Paumanok/kasa-remote/README.md

# Kasa-remote

An ESP32 based remote control device for manipulating and monitoring TPLink Kasa devices.

Future plans include new control modules, power saving, and other nice-to-haves. 

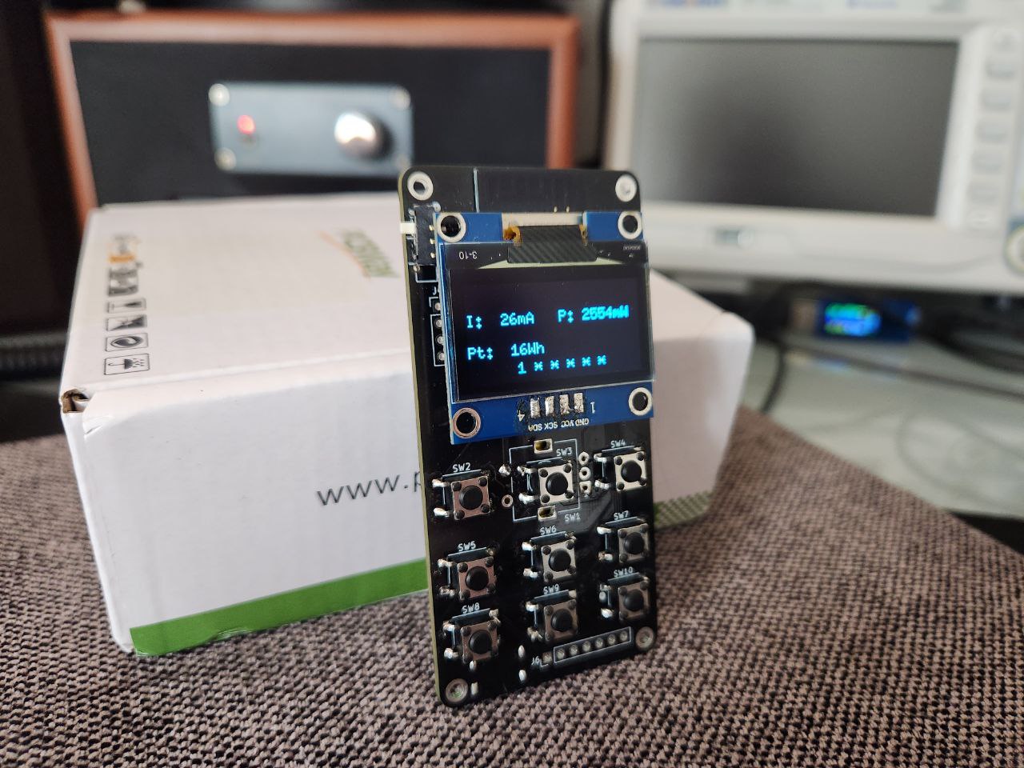
[picture p1: hardware/Assembled.jpg]
assembled


Leverages [rust_kasa](https://github.com/Paumanok/rust_kasa)
