Paumanok/kasa-remote/hardware/Documentation/kasa-remote-bom.ods

Source: | /home/matt/Documents/Projects/Hardware/kasa-remote/kasa-remote.kicad_sch
Date: | Mon 11 Mar 2024 04:03:01 PM EDT
Tool: | Eeschema 7.0.10
Generator: | /usr/share/kicad/plugins/bom_csv_grouped_by_value.py
Component Count: | 46
Collated Components:
Item | Qty | Owned | Reference(s) | Value | LibPart | Footprint | Datasheet | DNP | Availability | Check_prices | Description | MANUFACTURER | MAXIMUM_PACKAGE_HEIGHT | MF | MP | Mfg Part # | PARTREV | Package | Price | STANDARD | Sim.Device | Sim.Pins | Sim.Type | SnapEDA_Link | mpn
1 | 4 |  | C1, C2, C3, C4 | 10uf | Device:C_Small | Capacitor_SMD:C_0603_1608Metric | ~ |  |  |  | https://www.digikey.com/en/products/detail/taiyo-yuden/JMK107ABJ106MA-T/4970720
2 | 1 |  | C5 | .1uf | Device:C_Polarized_Small_US | Capacitor_SMD:C_0603_1608Metric | ~ |  |  |  | https://www.digikey.com/en/products/detail/vishay-sprague/TMCP1D104MTRF/10107432
3 | 1 | yes | C6 | 1uf | Device:C_Small | Capacitor_SMD:C_0603_1608Metric | ~
4 | 1 |  | D1 | LED | Device:LED | LED_SMD:LED_0603_1608Metric | ~
5 | 1 |  | D2 | CUHS20 | Device:D_Schottky | cuh:US2H_TOS | ~ |  |  |  | https://www.digikey.com/en/products/detail/toshiba-semiconductor-and-storage/CUHS20F30-H3F/9749632
6 | 4 | yes | H1, H2, H3, H4 | MountingHole_Pad | Mechanical:MountingHole_Pad | MountingHole:MountingHole_2.2mm_M2_DIN965_Pad_TopBottom | ~
7 | 1 | yes | J1 | USB4105-GF-A | USB4105-GF-A:USB4105-GF-A | USB4105-GF-A:GCT_USB4105-GF-A |  |  | In Stock | https://www.snapeda.com/parts/USB4105GFA/Global+Connector+Technology/view-part/?ref=eda | USB-C (USB TYPE-C) USB 2.0 Receptacle Connector 24 (16+8 Dummy) Position Surface Mount, Right Angle; Through Hole | Global Connector Technology | 3.31mm | Global Connector Technology | USB4105GFA |  | B3 | None | None | Manufacturer Recommendations |  |  |  | https://www.snapeda.com/parts/USB4105GFA/Global+Connector+Technology/view-part/?ref=snap
8 | 1 |  | J2 | S2B-PH-SM4-TB | JST-header:S2B-PH-SM4-TB | S2B_PH:CONN_S2B-PH-SM4-TB_JST | S2B-PH-SM4-TB |  |  |  | https://www.digikey.com/en/products/detail/jst-sales-america-inc/S2B-PH-SM4-TB/926655
9 | 1 | yes | J3 | sh1106_vert | Connector_Generic:Conn_01x04 | Connector_PinHeader_2.54mm:PinHeader_1x04_P2.54mm_Vertical | ~
10 | 1 | yes | J4 | sh1106_horiz | Connector_Generic:Conn_01x04 | Connector_PinHeader_2.54mm:PinHeader_1x04_P2.54mm_Vertical | ~
11 | 1 | yes | J6 | Button_breakout | Connector_Generic:Conn_01x07 | Connector_PinHeader_2.54mm:PinHeader_1x07_P2.54mm_Vertical | ~
12 | 1 |  | Q1 | DMP2045U-7 | Simulation_SPICE:PMOS | DMP2045U:SOT-23_DIO | https://www.diodes.com/assets/Datasheets/DMP2045U.pdf |  |  |  | https://www.digikey.com/en/products/detail/diodes-incorporated/DMP2045U-7/8275356 |  |  |  |  | DMP2045U-7 |  |  |  |  | PMOS | 1=D 2=G 3=S | VDMOS
13 | 2 | yes | R1, R2 | 22 | Device:R_Small | Resistor_SMD:R_0603_1608Metric | ~ |  |  |  |  |  |  |  |  | CR0603-FX-22R0ELF |  |  |  |  |  |  |  |  | CR0603-FX-22R0ELF
14 | 2 |  | R3, R4 | 5.6k | Device:R_Small | Resistor_SMD:R_0603_1608Metric | ~
15 | 2 |  | R5, R11 | 5.1k | Device:R_Small | Resistor_SMD:R_0603_1608Metric | ~
16 | 3 |  | R6, R9, R10 | 2k | Device:R_Small | Resistor_SMD:R_0603_1608Metric | ~
17 | 2 |  | R7, R8 | 100k | Device:R_Small | Resistor_SMD:R_0603_1608Metric | ~
18 | 1 | yes | SW1 | RotaryEncoder_Switch | Device:RotaryEncoder_Switch | Rotary_Encoder:RotaryEncoder_Alps_EC11E-Switch_Vertical_H20mm | ~
19 | 9 |  | SW2, SW3, SW4, SW5, SW6, SW7, SW8, SW9, SW10 | SW_Push | Switch:SW_Push | Button_Switch_SMD:SW_SPST_PTS645 | ~ |  |  |  |  |  |  |  |  |  |  |  |  |  |  |  |  |  | CKN10880CT-ND
20 | 1 | 2 | SW11 | RESET | Switch:SW_Push | Button_Switch_SMD:SW_SPST_PTS810 | ~ |  |  |  |  |  |  |  |  |  |  |  |  |  |  |  |  |  | PTS815 SJM 250 SMTR LFS
21 | 1 |  | SW12 | BOOT0 | Switch:SW_Push | Jumper:SolderJumper-2_P1.3mm_Open_RoundedPad1.0x1.5mm | ~
22 | 1 |  | SW13 | CSS-1210TB | CSS-1210TB:CSS-1210TB | CSS-1210TB:CSS-1210TB_NDC | CSS-1210TB |  |  |  | https://www.digikey.com/en/products/detail/nidec-components-corporation/CSS-1210TB/1124209
23 | 1 |  | U1 | ESP32-S3-WROOM-1-N4 | ESP32-S3-WROOM-1-N4:ESP32-S3-WROOM-1-N4 | PCM_Espressif:ESP32-S3-WROOM-1 |  |  |  |  | https://www.digikey.com/en/products/detail/espressif-systems/ESP32-S3-WROOM-1-N8/15200089 | Espressif | 3.25mm |  |  |  | v1.0 |  |  | Manufacturer Recommendations
24 | 1 |  | U2 | MAX17048G+T10 | max17048:MAX17048G+T10 | MAX17048:21-0168E_T822-3_MXM | MAX17048G+T10 |  |  |  | https://www.digikey.com/en/products/detail/analog-devices-inc-maxim-integrated/MAX17048G-T10/3758921
25 | 1 |  | U4 | MCP73831T-2ACI/OT | MCP7381:MCP73831T-2ACI_OT | MCP7381:SOT-23-5_MC_MCH | MCP73831T-2ACI/OT |  |  |  | https://www.digikey.com/en/products/detail/microchip-technology/MCP73831T-2ACI-OT/964301
26 | 1 |  | U5 | AP2112K-3.3 | Regulator_Linear:AP2112K-3.3 | Package_TO_SOT_SMD:SOT-23-5 | https://www.diodes.com/assets/Datasheets/AP2112.pdf |  |  |  | https://www.digikey.com/en/products/detail/diodes-incorporated/AP2112K-3-3TRG1/4470746
