Paumanok/kasa-remote/hardware/Documentation/bom_scratch.ods

Kasa-remote Design bom notes
Part Number | Description | footprint | url | Notes
MAX17048G+T10 | battery fuel gauge | TDFN | https://www.digikey.com/en/products/detail/analog-devices-inc-maxim-integrated/MAX17048G-T10/3758921
MCP73831T-2ACI/OT | Single cell Li-on charge controller | 5-lead SOT-23 | https://www.digikey.com/en/products/detail/microchip-technology/MCP73831T-2ACI-OT/964301
DMP2045U | P-channel reverse current protection diode | SOT23-3 | https://www.digikey.com/en/products/detail/diodes-incorporated/DMP2045U-7/8275356
AP2112 | Low-dropout linear regulator | SOT25 | https://www.digikey.com/en/products/detail/diodes-incorporated/AP2112K-3-3TRG1/4470746
ESP32-S3-WROOM-1-N8 | mcu |  | https://www.digikey.com/en/products/detail/espressif-systems/ESP32-S3-WROOM-1-N8/15200089 | Schematic listing N4 but price difference is 30 cents, a consideration for prod, but not for me
Lithium Polymer Battery 3.7V 1100mAh 603449 | lipo battery | JSH-PHR-02 | https://www.amazon.com/EEMB-1100mAh-Battery-Rechargeable-Connector/dp/B08FD39Y5R | not sure the difference between lion and lipo
S2B-PH-SM4-TB | battery jst header | Sm-ra | https://www.digikey.com/en/products/detail/jst-sales-america-inc/S2B-PH-SM4-TB/926655 | surface mount right angle. https://www.mattmillman.com/info/crimpconnectors/common-jst-connector-types/
CSS-1210TB | power switch |  | https://www.digikey.com/en/products/detail/nidec-components-corporation/CSS-1210TB/1124209
