Paumanok/kasa-remote/hardware/kasa-remote.kicad_pcb

## KiCad design hardware/kasa-remote.kicad_pcb (2024-03-12)

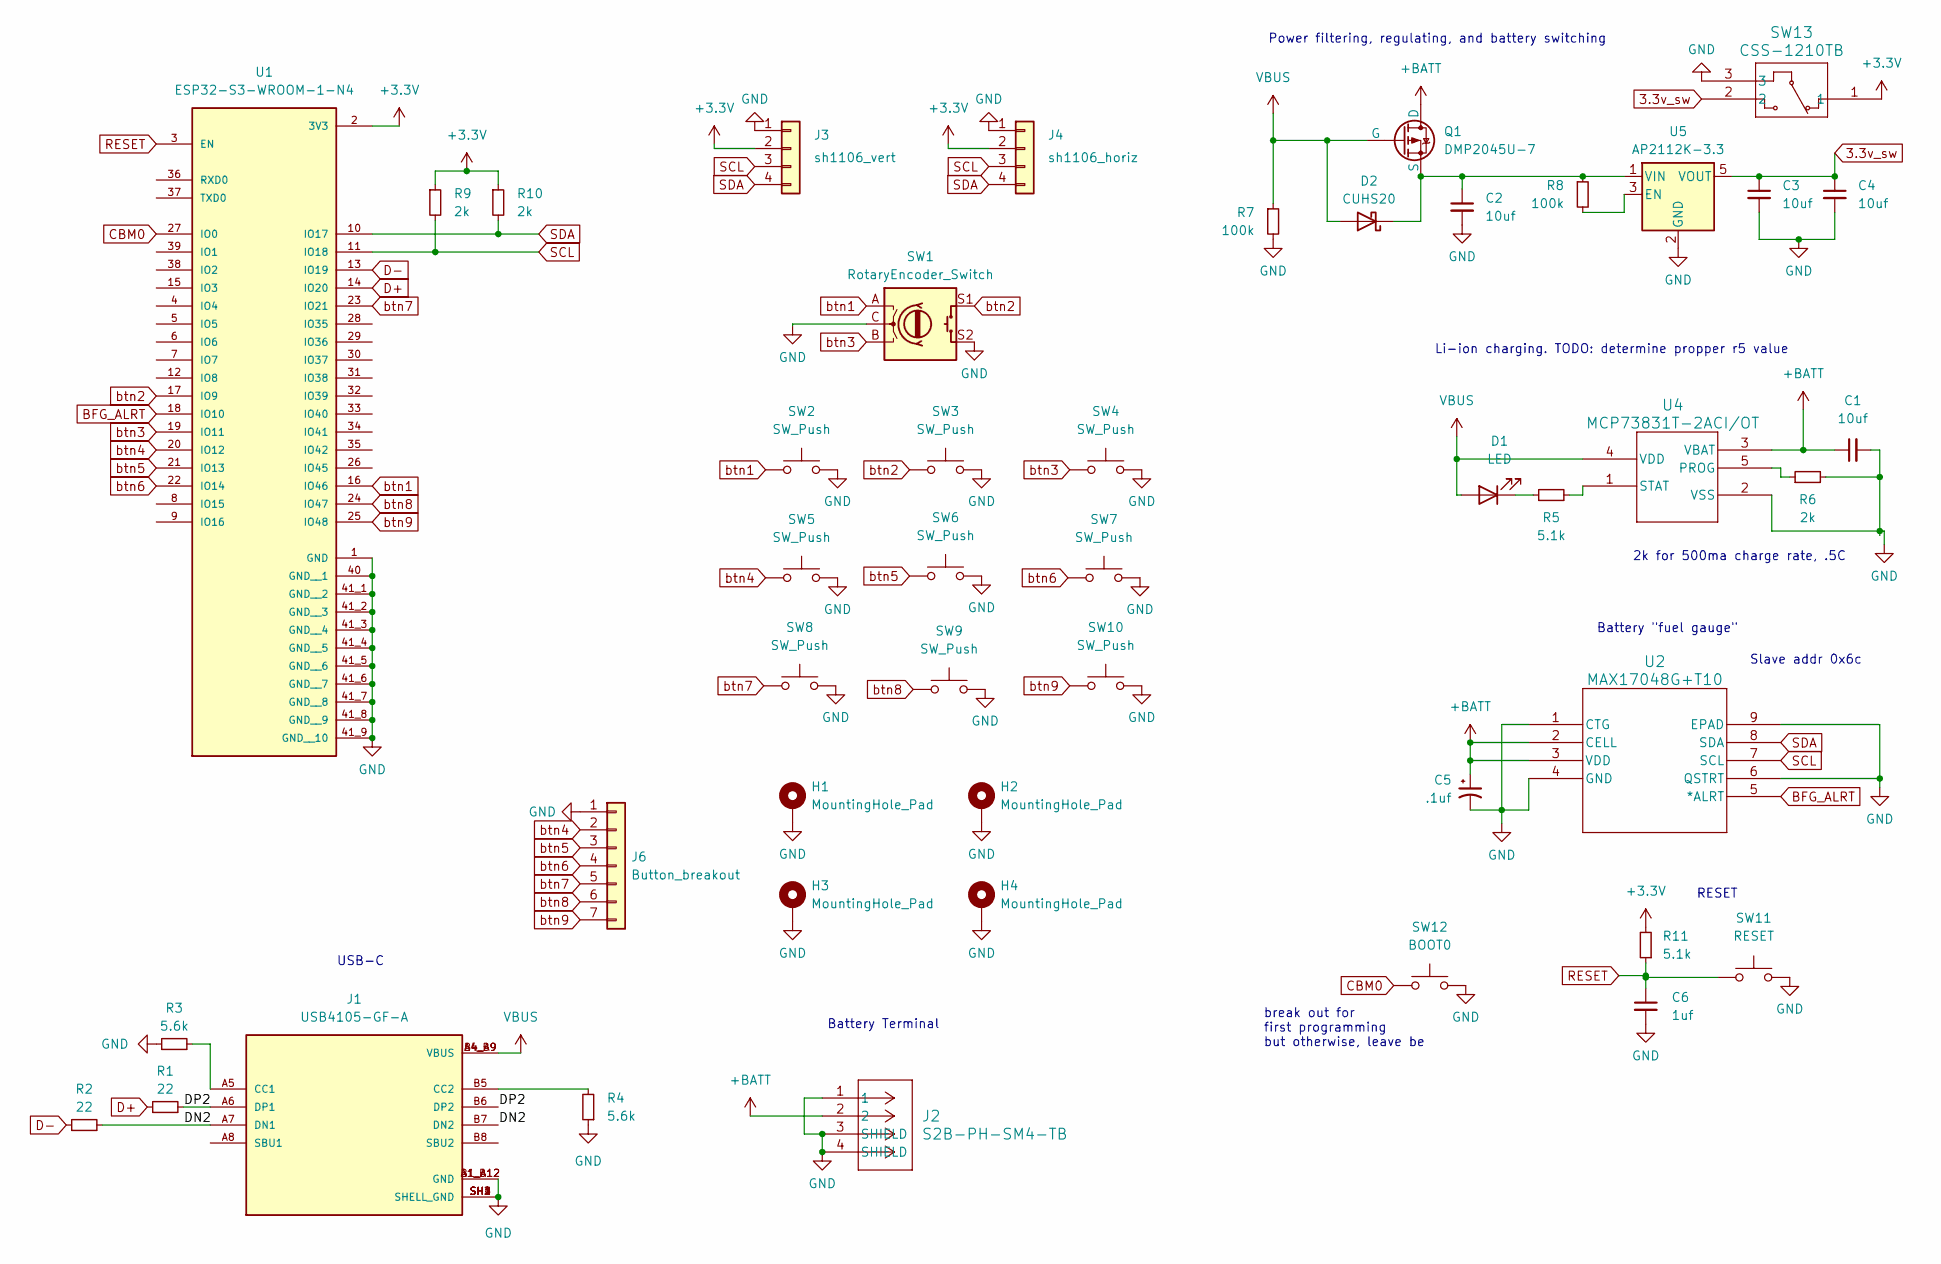
[picture p2: schematic kasa-remote.kicad_sch]

Parts:
C1, C2, C3, C4: 10uf; C_0603_1608Metric
C5: .1uf; C_0603_1608Metric
C6: 1uf; C_0603_1608Metric
D1: LED; LED_0603_1608Metric
D2: CUHS20; US2H_TOS
H1, H2, H3, H4: MountingHole_Pad; MountingHole_2.2mm_M2_DIN965_Pad_TopBottom
J1: USB4105-GF-A; GCT_USB4105-GF-A; PARTREV B3
J2: S2B-PH-SM4-TB; CONN_S2B-PH-SM4-TB_JST
J3: sh1106_vert; PinHeader_1x04_P2.54mm_Vertical
J4: sh1106_horiz; PinHeader_1x04_P2.54mm_Vertical
J6: Button_breakout; PinHeader_1x07_P2.54mm_Vertical
Q1: DMP2045U-7; SOT-23_DIO; Mfg Part # DMP2045U-7
R1, R2: 22; R_0603_1608Metric; mpn CR0603-FX-22R0ELF
R3, R4: 5.6k; R_0603_1608Metric
R5, R11: 5.1k; R_0603_1608Metric
R6, R9, R10: 2k; R_0603_1608Metric
R7, R8: 100k; R_0603_1608Metric
SW1: RotaryEncoder_Switch; RotaryEncoder_Alps_EC11E-Switch_Vertical_H20mm
SW2, SW3, SW4, SW5, SW6, SW7, SW8, SW9, SW10: SW_Push; SW_SPST_PTS645; mpn CKN10880CT-ND
SW11: RESET; SW_SPST_PTS810; mpn PTS815 SJM 250 SMTR LFS
SW12: BOOT0; SolderJumper-2_P1.3mm_Open_RoundedPad1.0x1.5mm
SW13: CSS-1210TB; CSS-1210TB_NDC
U1: ESP32-S3-WROOM-1-N4; ESP32-S3-WROOM-1; PARTREV v1.0
U2: MAX17048G+T10; 21-0168E_T822-3_MXM
U4: MCP73831T-2ACI/OT; SOT-23-5_MC_MCH
U5: AP2112K-3.3; SOT-23-5

Connections:
3.3v_sw: C3.1, C4.1, SW13.2, U5.5 (VOUT)
+3.3V: J3.2, J4.2, R9.1, R10.1, R11.2, SW13.1, U1.2 (3V3)
+BATT: C1.1, C5.1, J2.2, Q1.1 (D), U2.2 (CELL), U2.3 (VDD), U4.3 (VBAT)
/DN2: J1.A7 (DN1), J1.B7 (DN2), R2.2
/DP2: J1.A6 (DP1), J1.B6 (DP2), R1.2
BFG_ALRT: U1.18 (IO10), U2.5 (*ALRT)
CBM0: SW12.1, U1.27 (IO0)
D+: R1.1, U1.14 (IO20)
D-: R2.1, U1.13 (IO19)
GND: C1.2, C2.2, C3.2, C4.2, C5.2, C6.2, H1.1, H2.1, H3.1, H4.1, J1.A1_B12 (GND), J1.B1_A12 (GND), J1.SH1 (SHELL_GND), J1.SH2 (SHELL_GND), J1.SH3 (SHELL_GND), J1.SH4 (SHELL_GND), J2.1, J2.3 (SHIELD), J2.4 (SHIELD), J3.1, J4.1, J6.1, R3.1, R4.1, R6.2, R7.2, SW1.C, SW1.S2, SW2.2, SW3.2, SW4.2, SW5.2, SW6.2, SW7.2, SW8.2, SW9.2, SW10.2, SW11.2, SW12.2, SW13.3, U1.1 (GND), U1.40 (GND__1), U1.41_1 (GND__2), U1.41_2 (GND__3), U1.41_3 (GND__4), U1.41_4 (GND__5), U1.41_5 (GND__6), U1.41_6 (GND__7), U1.41_7 (GND__8), U1.41_8 (GND__9), U1.41_9 (GND__10), U2.1 (CTG), U2.4 (GND), U2.6 (QSTRT), U2.9 (EPAD), U4.2 (VSS), U5.2 (GND)
unnamed: D1.1 (K), R5.1
unnamed: C2.1, D2.1 (K), Q1.3 (S), R8.1, U5.1 (VIN)
unnamed: J1.A5 (CC1), R3.2
unnamed: J1.B5 (CC2), R4.2
unnamed: R6.1, U4.5 (PROG)
unnamed: R5.2, U4.1 (STAT)
unnamed: R8.2, U5.3 (EN)
RESET: C6.1, R11.1, SW11.1, U1.3 (EN)
SCL: J3.3, J4.3, R9.2, U1.11 (IO18), U2.7 (SCL)
SDA: J3.4, J4.4, R10.2, U1.10 (IO17), U2.8 (SDA)
VBUS: D1.2 (A), D2.2 (A), J1.A4_B9 (VBUS), J1.B4_A9 (VBUS), Q1.2 (G), R7.1, U4.4 (VDD)
btn1: SW1.A, SW2.1, U1.16 (IO46)
btn2: SW1.S1, SW3.1, U1.17 (IO9)
btn3: SW1.B, SW4.1, U1.19 (IO11)
btn4: J6.2, SW5.1, U1.20 (IO12)
btn5: J6.3, SW6.1, U1.21 (IO13)
btn6: J6.4, SW7.1, U1.22 (IO14)
btn7: J6.5, SW8.1, U1.23 (IO21)
btn8: J6.6, SW9.1, U1.24 (IO47)
btn9: J6.7, SW10.1, U1.25 (IO48)

Notes on the sheet:
Power filtering, regulating, and battery switching
RESET
Slave addr 0x6c
Battery "fuel gauge"
Li-ion charging. TODO: determine propper r5 value
break out for first programming but otherwise, leave be
2k for 500ma charge rate, .5C
USB-C
Battery Terminal

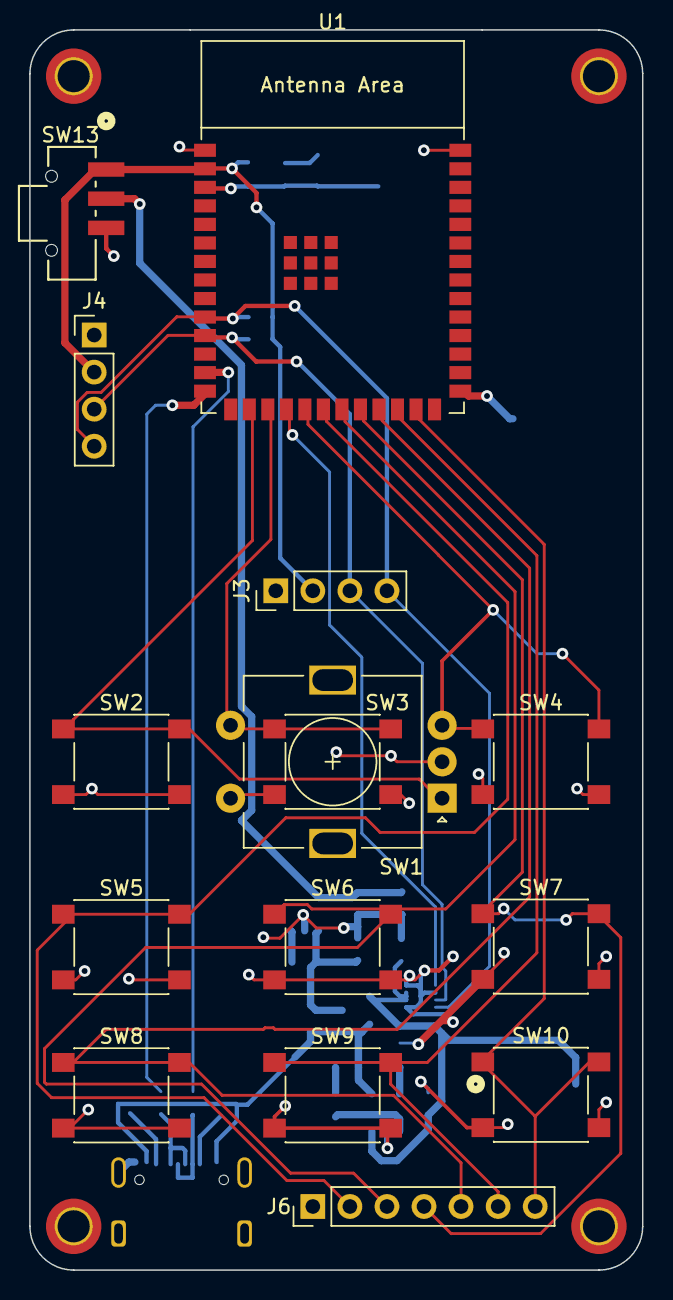
[picture p3: board kasa-remote.kicad_pcb from above]

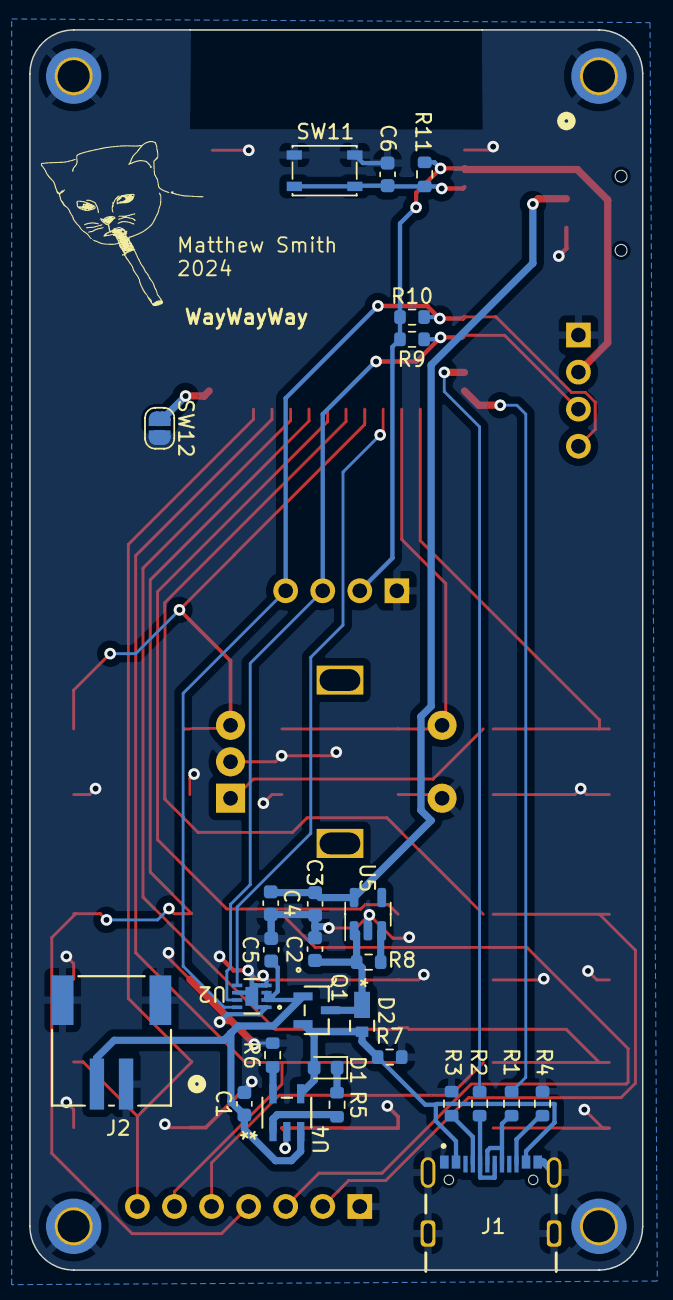
[picture p4: board kasa-remote.kicad_pcb from below]

Board: 2 copper layers, 42.0 x 85.0 mm, 46 parts (27 on the bottom side), 30 nets.
