Paumanok/kasa-remote/src/peripheral_util/wifi.rs

//Modified from wifi lib in https://github.com/esp-rs/std-training

use anyhow::{bail, Result};
use esp_idf_svc::{
    eventloop::EspSystemEventLoop,
    hal::peripheral,
    wifi::{AuthMethod, BlockingWifi, ClientConfiguration, Configuration, EspWifi},
};

pub fn wifi(
    ssid: &str,
    pass: &str,
    modem: impl peripheral::Peripheral<P = esp_idf_svc::hal::modem::Modem> + 'static,
    sysloop: EspSystemEventLoop,
    scan: bool,
) -> Result<Box<EspWifi<'static>>> {
    let mut auth_method = AuthMethod::WPA;
    if ssid.is_empty() {
        bail!("Missing WiFi name")
    }
    if pass.is_empty() {
        auth_method = AuthMethod::None;
        log::info!("Wifi password is empty");
    }
    let mut esp_wifi = EspWifi::new(modem, sysloop.clone(), None)?;

    let mut wifi = BlockingWifi::wrap(&mut esp_wifi, sysloop)?;

    wifi.set_configuration(&Configuration::Client(ClientConfiguration::default()))?;

    log::info!("Starting wifi...");

    wifi.start()?;

    let channel = if scan {
        log::info!("Scanning...");

        let ap_infos = wifi.scan()?;

        let ours = ap_infos.into_iter().find(|a| a.ssid == ssid);

        let channel = if let Some(ours) = ours {
            log::info!(
                "Found configured access point {} on channel {}",
                ssid,
                ours.channel
            );
            Some(ours.channel)
        } else {
            log::info!(
                "Configured access point {} not found during scanning, will go with unknown channel",
                ssid
            );
            None
        };
        channel
    } else {
        None
    };

    wifi.set_configuration(&Configuration::Client(ClientConfiguration {
        ssid: ssid.try_into().unwrap(),
        password: pass.try_into().unwrap(),
        channel,
        auth_method,
        ..Default::default()
    }))?;

    log::info!("Connecting wifi...");

    wifi.connect()?;

    log::info!("Waiting for DHCP lease...");

    wifi.wait_netif_up()?;

    let ip_info = wifi.wifi().sta_netif().get_ip_info()?;

    log::info!("Wifi DHCP info: {:?}", ip_info);

    Ok(Box::new(esp_wifi))
}
