Paumanok/kasa-remote/(commit log)

2024-02-10 making it more complex, laying ground work for some threads
2024-02-11 code is quite messy but I've got some threaded tasks going for updating the display and getting live data
2024-02-12 made some stability improvements with more error checking. Added some wifi reconnect logic.
    [main.rs]
2024-02-14 drafting the UI and trying to get the encoder going. currently broken
    [main.rs]
2024-02-14 found a nice blog post, encoder working nice
2024-02-16 changed encoder implementation, not currently wired up to send current val to display service. Going to re-do how everything is interconnected. Still a little slow for my liking so I may need to sepa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
2024-02-17 switched from channels to a Arc<Mutex<>> and set up an api polling thread and things are a lot snappier. Happy with the responsiveness of the encoder for now
    [main.rs]
2024-02-17 cleaned up the encoder service, removing the need to specify the pin in the function signature
2024-03-04 putting the kicad stuff into git
    [bom_scratch.ods, kasa-remote.kicad_pcb, kasa-remote.kicad_sch]
2024-03-05 starting pcb work, might need to add more to the gitignore
    [kasa-remote.kicad_pcb, kasa-remote.kicad_sch]
2024-03-06 fixed a couple mistakes in the schematic, organizing and starting layout
    [kasa-remote.kicad_pcb, kasa-remote.kicad_sch]
2024-03-10 layout just about done, no more errors at least
    [bom_scratch.ods, kasa-remote.kicad_pcb, kasa-remote.kicad_sch]
2024-03-10 still tweaking silkscreens
    [kasa-remote.kicad_pcb]
2024-03-10 cleaned up the silkscreen errors
    [kasa-remote.kicad_pcb]
2024-03-10 just about done, I think I want to move the horizontal display over a bit so it's symetrical to the pcb
    [kasa-remote.kicad_pcb]
2024-03-12 added the waywayway for pcb way, also added the bom spreadsheet
    [kasa-remote-bom.ods, kasa-remote.kicad_pcb, kasa-remote.kicad_sch]
2024-03-19 doing bringup on the new pcb
    [partitions.csv]
2024-03-20 all the buttons brought up and functioning. I need to figure out a real debounce strategy
2024-03-23 added proper button debouncing and broke out button actions from service
    [buttons.rs]
2024-03-27 no longer can do remote things right now but the module dispatcher is functional
    [buttons.rs, main.rs, module_runner.rs]
2024-04-02 still not working, but started moving kasa stuff to new runner framework in order to work out practical necessities
    [buttons.rs, display.rs, main.rs, module_runner.rs]
2024-04-02 trying the dual mpsc route, hoping the delay isn't too bad, almost done wiring it up
2024-04-02 proof of concept module thread switching with display and IO channels
2024-04-02 reintroduced wifi to the mix, i have my light switch back. Also ran cargo fmt so a lot of small changes there
2024-04-04 worked out some better flow control that makes display updates snappier
    [display.rs, kasa_control.rs, module_runner.rs]
2024-04-07 starting integration for the battery monitor, turns out the singleton i2c bus is going to cause some issues
    [battery_monitor.rs, display.rs, main.rs, wifi.rs]
2024-04-08 not working but its getting closer
    [display.rs, main.rs]
2024-04-08 thank you dirbaio on the rust embedded matrix for showing me box::leak
    [main.rs]
2024-04-09 good news: max170xx working, bad news: whole new bottle of worms to put that i2c handle into the BatteryMonitor struct. it will be a tomorrow problem. otherwise, we have a shared i2c device bus acros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
    [battery_monitor.rs, display.rs, main.rs, module_runner.rs]
2024-04-10 sensor working, need some display improvements
2024-04-10 added a stopgap solution for selectively clearing the display so I can have both battery% and current module displaying at once
2024-04-13 moved wifi init, added some state to the battery reading
2024-04-13 something broke wifi, investigating
    [battery_monitor.rs, display.rs, kasa_control.rs, main.rs, module_runner.rs]
2024-04-13 readding clear_rect, still unsure what is causing the issue
    [battery_monitor.rs, display.rs, kasa_control.rs, module_runner.rs]
2024-04-16 Cleaning up some comments, added a display_error function, to provide a quick interface for throwing a visual error on the display. Moved the wifi module into peripheral util. Cleaned up cargo.toml. 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
    [display.rs, main.rs, module_runner.rs, wifi.rs]
2024-08-18 reworking display a little bit to accept an arbitrary buffer as a render option
    [battery_monitor.rs, display.rs, kasa_control.rs, main.rs, module_runner.rs]
2024-09-01 broke test module into its own file, moved module definition out of the moduleRunner constructor, made the snek move like a snek
    [main.rs, module_runner.rs]
2024-12-07 starting to add support for multiple devices to control
